BrettKnox/wk10-rc-car/cad/out/wk10_assembly.step

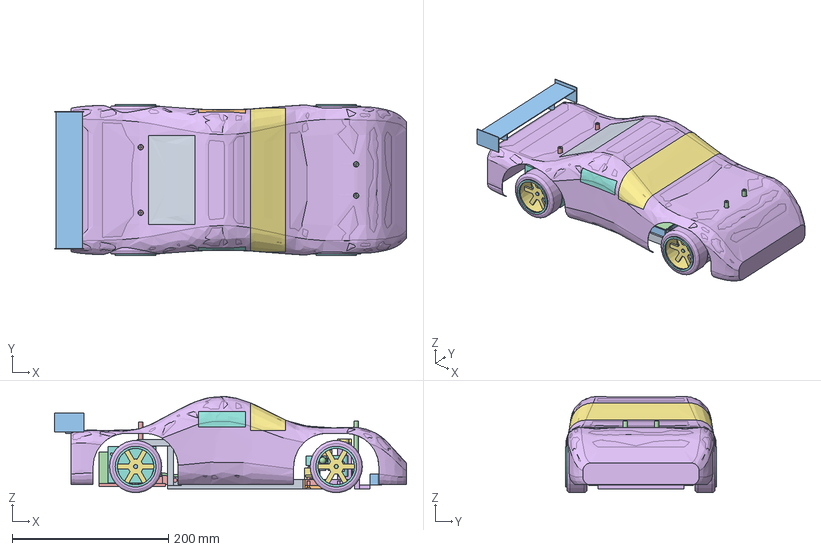
[picture p2: CAD file, 2026-10-13]
cad/out/wk10_assembly.step
450.9 x 194.0 x 123.1 mm
