BrettKnox/wk10-rc-car/(commit log)

2026-10-12 WK-10 v0: parametric pan car, fit checks, ESP-NOW firmware
    [wk10_assembly.step]
2026-10-12 Solve steering linkage: rearward horn, printed adjustable tie rods, Ackermann/bump checks
    [wk10_assembly.step]
2026-10-12 Phone/API control, NVS tuning, battery limp mode, boot self-test; spur clamp; 14T gearing
    [wk10_assembly.step]
2026-10-12 README: priced BOM under 300, steering/tie rods, phone and API driving, bring-up
2026-10-12 Firmware safety fixes from review: control task, arming gate, boot neutral, bound TX + seq, parked-only config/OTA, pot fault, host selftest
    [car_rx.ino, host_selftest.cpp, tx.ino]
2026-10-12 CAD fixes from review: true-Ackermann linkage with tracked solver, pod rail joint, D-bore spool + collars, spring arm kept, splice/front-end inserts, pivot float, stricter checks incl. bought parts
    [wk10_assembly.step]
2026-10-12 README: corrected steering, assembly, arming and safety model, host selftest
2026-10-12 Print-ready STLs in slicer orientation, calibration coupon, printability fixes (tie-rod boss, insert caps, spool flange)
    [bump_stops.step, bump_stops.stl, calibration_coupon.step, calibration_coupon.stl, esp32_tray.step, esp32_tray.stl, front_end.step, front_end.stl]
2026-10-12 Ignore regenerated print exports
    [bump_stops.step, bump_stops.stl, calibration_coupon.step, calibration_coupon.stl, esp32_tray.step, esp32_tray.stl, front_end.step, front_end.stl]
2026-10-12 Review round 2: ESC calibration mode, 300 ms WDT, OTA lockout, VBAT off by default, TX mV pots, drive.py abort + fake-car test, pivot float, knuckle print pose, race/spring shims, D-bore comp, steeri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
    [wk10_assembly.step]
2026-10-12 Tie-rod sweep at both locks; README synced with review round 2 (calibration, bench power, axle retention, rear spring, VBAT, TX pots)
    [wk10_assembly.step]
2026-10-12 Review round 3: phone-only 30 s ESC calibration that cancels on source change and expiry, WDT ISR cuts ESC signal, relaxed WDT during flash writes, TX rail + linear-range pots, drive.py refuses calib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
    [wk10_assembly.step]
2026-10-12 Deepen tie-rod bar for buckling margin; add drawing set and review packet
    Tie rod 6x3 bar buckled at ~69 N, below the MG996R's ~90 N stall push.
    Bar is now 5 mm deep away from the eyes (SF 3.5) and wk10.py asserts SF >= 2.
    sheets.py generates five dimensioned HLR drawing sheets, chart data and
    per-part meshes; review/build.py inlines them into the review page.
    [wk10_assembly.step]
2026-10-12 Model the bought parts and body; narrow track to 164 mm for a 190 mm body
    bought.py models every bought part from published dimensions (rims and tires,
    QR3650, 10BL60 G2, MG996R and horn, ESP32-DevKitC V4, 2S pack, 48P gears,
    Venturi GT shell, windows and wing). The detailed parts exposed what the
    envelopes hid, each now fixed and checked:
    - 201 mm over the tires could not take a 190 mm body: track 175 -> 164,
    kingpins and knuckles moved in, steering re-solved (98% Ackermann,
    16 mm arm, 14 mm horn), pan front corners narrowed
    - ESP32 tray could not hold a DevKitC (no holes, pins 8.5 mm under):
    cradle + lid that captures the module shield
    - servo lead exits under the rear ear post: tunn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
    [wk10_assembly.step]
2026-10-13 Rev F: fix the Rev E review's P0s and move control to a hobby radio
    A three-way hostile review of Rev E found an uninstallable knuckle
    bearing, a 1.2 mm pod lug neck, a 1 mm pinion face overlap and a
    335 m coast on link loss.
    - Kingpin moved 10.5 mm ahead of the axle (trail, and both knuckle
    bearings now press in from outboard); hardened pins in brass bushes
    - Low-profile servo through the pan, servo saver, ball-cup tie rods;
    steering re-solved to 99% Ackermann with the 3D rod length
    - Clamping wheel hexes, flange-coupling spool, two oil coilovers,
    foam bumper, gear cover, battery stop, all posts on the pan, PETG
    - load_cases() and new checks: bearing insertion, gear face, shaft
    rea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
    [wk10_assembly.step]
